paulfaget/SalamanderSensorDataLoggerProject/Images/Overview.jpg

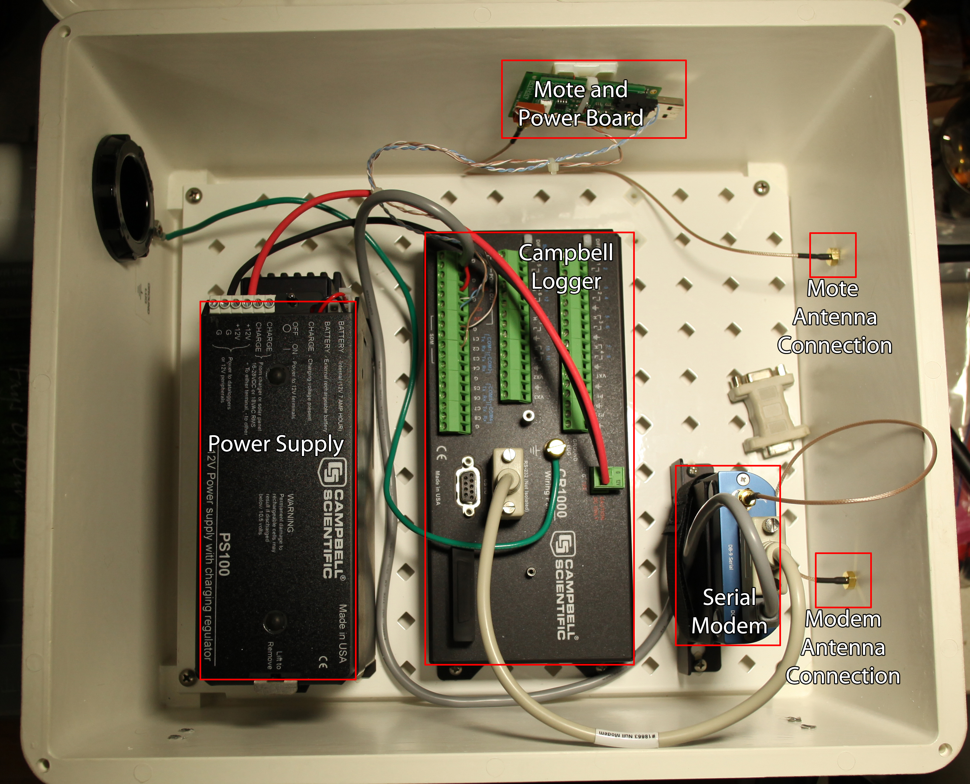
Images/Overview.jpg
