paulfaget/SalamanderSensorDataLoggerProject/Images/Mote.jpg

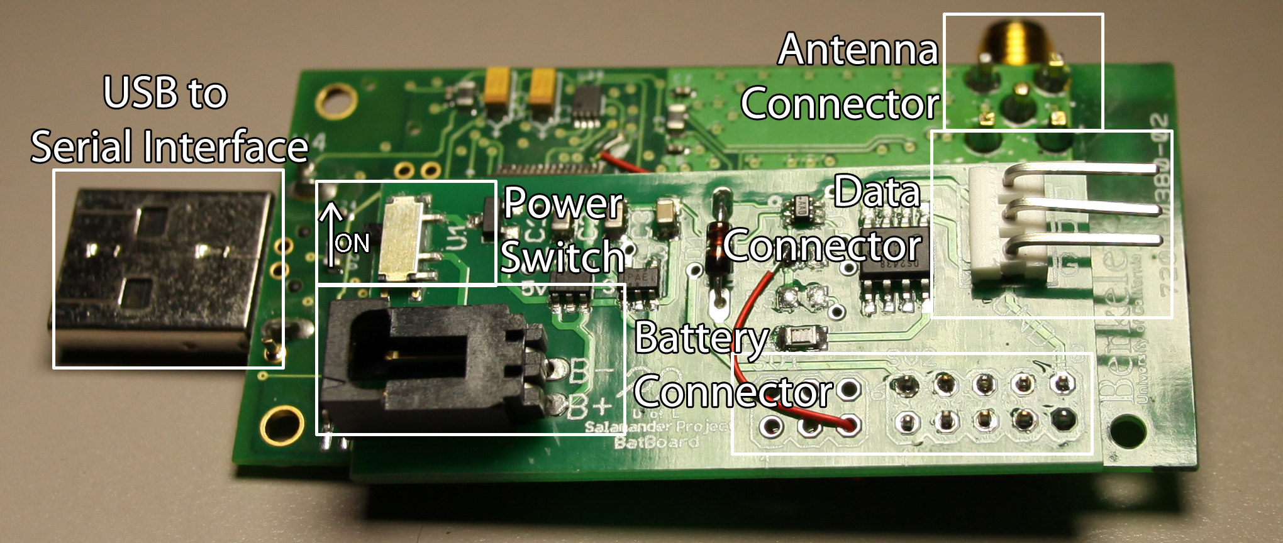
Images/Mote.jpg
