paulfaget/SalamanderSensorDataLoggerProject/Images/Campbell.jpg

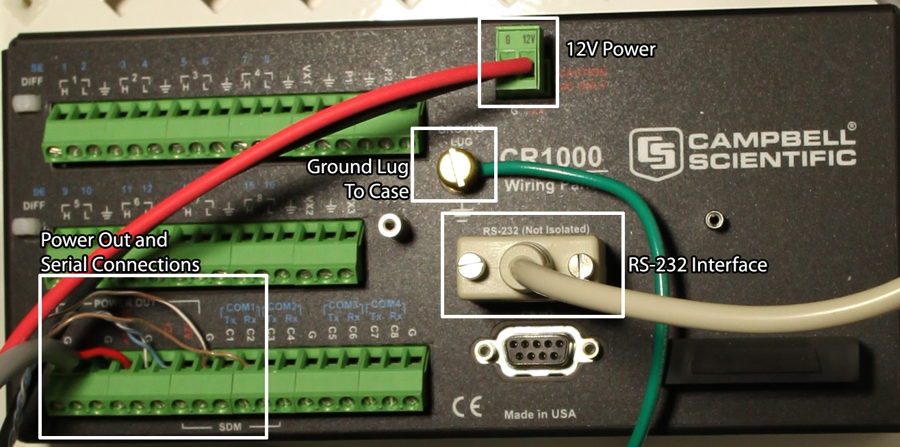
Images/Campbell.jpg
