paulfaget/SalamanderSensorDataLoggerProject/Images/Modem.jpg

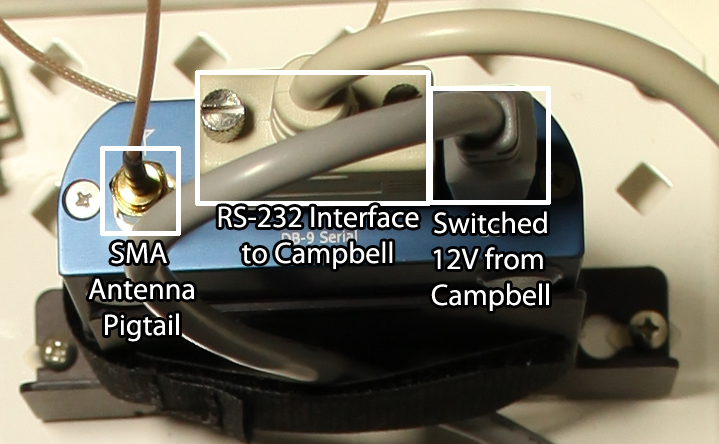
Images/Modem.jpg
