paulfaget/SalamanderSensorDataLoggerProject/Images/Power Source.jpg

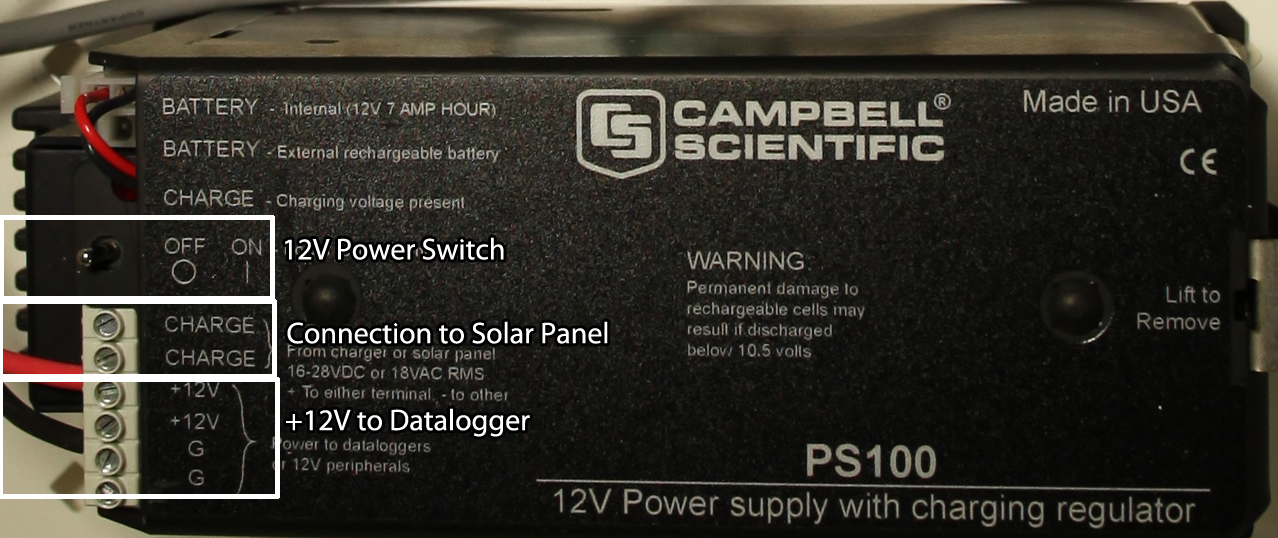
Images/Power Source.jpg
