paulfaget/SalamanderSensorDataLoggerProject/Power Board/BOM.xls

Salamander PowerBoard
Bill of Materials
Label | Purpose | Value | PKG | Digi-Key PN | Sparkfun PN
R1 | 1-Wire Pullup | 4.7kΩ | 805 | RR12P4.7KDCT-ND
R2 | UART Level Translator | 0Ω | 805
R3 | 1Wire Level Translator | 0Ω | 805
C1 | 5V Filter Cap | 4.7uF | 805 | 587-1301-1-ND
C2 | 3V Filter Cap | 4.7uF | 805 | 587-1301-1-ND
C3 | 6V Filter Cap | 1uF | 805 | PCC2319CT-ND
U1 | Reverse Polarity Battery Protection | NFET | SOT-23-3 | IRLML2502PBFCT-ND
U2 | 5V Regulator |  | SOT-23-5 | 296-11012-1-ND
U3 | 3V Regulator |  | SOT-23-5 | 296-11008-1-ND
U4 | Battery Monitor |  | 8-SOIC | DS2438Z+-ND
U5 | Level Translator | 3-5V Bidirectional | SC-70 | MAX3371EXT+TTC-ND
D1 | Current Shunt Diode | 1N4148 | Through Hole
S1 | Power Switch |  |  |  | COM-10860
X1 | 3Pin Sensor Connector | Rectangular RA |  | A19340-ND
X2 | Battery Connector
