paulfaget/SalamanderSensorDataLoggerProject/Power Board/PowerBoard.pdf

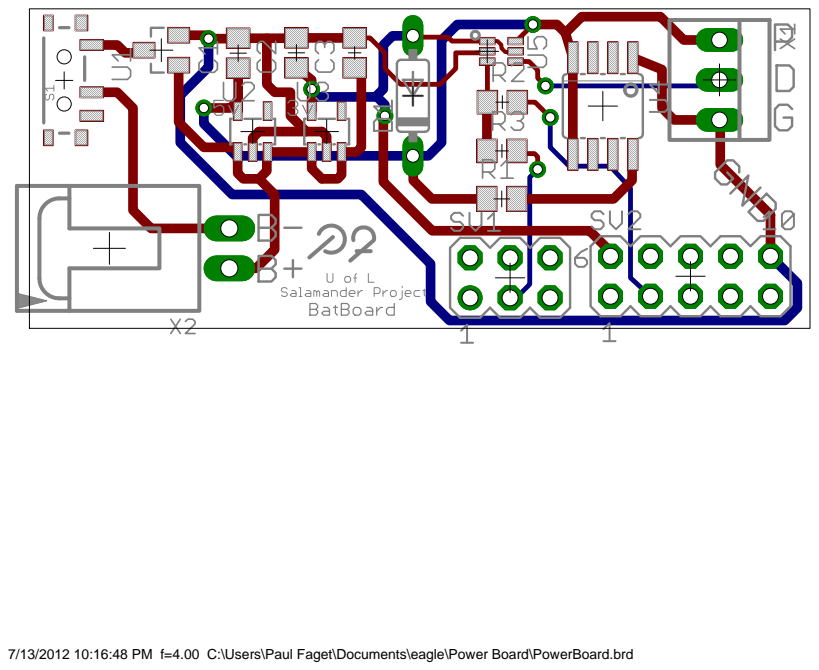
[picture p6: page 1]

7/13/2012 10:16:48 PM f=4.00 C:\Users\Paul Faget\Documents\eagle\Power Board\PowerBoard.brd
