paulfaget/SalamanderSensorDataLoggerProject/(list of files, drawings)

Other design files:
Power Board/Previous Version/ExpressPCB_PowerBoard.pcb
