paulfaget/SalamanderSensorDataLoggerProject/Power Board/PowerBoard.brd

## EAGLE design Power Board/PowerBoard.brd (2012-07-11)

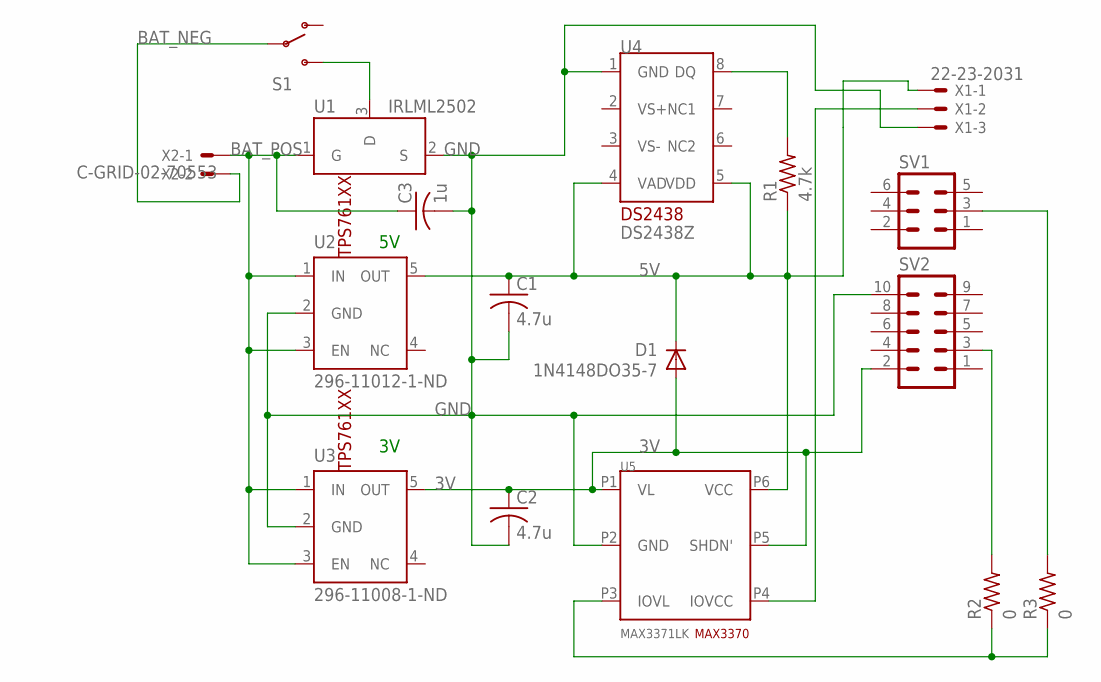
[picture p7: schematic PowerBoard.sch]

Parts:
C1, C2: 4.7u; C0805
C3: 1u; C0805
D1: 1N4148DO35-7; DO35-7
R1: 4.7k; M0805
R2, R3: 0; R0805
S1: SWITCH-SPST-SMD-A
SV1: MA03-2
SV2: MA05-2
U1: IRLML2502; SOT23
U2: 296-11012-1-ND; SOT23-DBV
U3: 296-11008-1-ND; SOT23-DBV
U4: DS2438Z; SOIC08
U5: MAX3371LK; 6-LEAD-SC70
X1: 22-23-2031
X2: C-GRID-02-70553; 70553-02

Connections:
3V: C2.1, D1.A, SV2.2, U3.5 (OUT), U5.P1 (VL), U5.P5 (SHDN')
5V: C1.1, D1.C, R1.1, U2.5 (OUT), U4.4 (VAD), U4.5 (VDD), U5.P6 (VCC), X1.1
BAT_NEG: S1.2, X2.2
BAT_POS: C3.1, U1.1 (G), U2.1 (IN), U2.3 (EN), U3.1 (IN), U3.3 (EN), X2.1
GND: C1.2, C2.2, C3.2, SV2.10, U1.2 (S), U2.2 (GND), U3.2 (GND), U4.1 (GND), U5.P2 (GND), X1.3
unnamed: R2.1, R3.1, U5.P3 (IOVL)
unnamed: S1.3 (S), U1.3 (D)
unnamed: R1.2, U4.8 (DQ)
unnamed: U5.P4 (IOVCC), X1.2
unnamed: R3.2, SV1.3
unnamed: R2.2, SV2.3

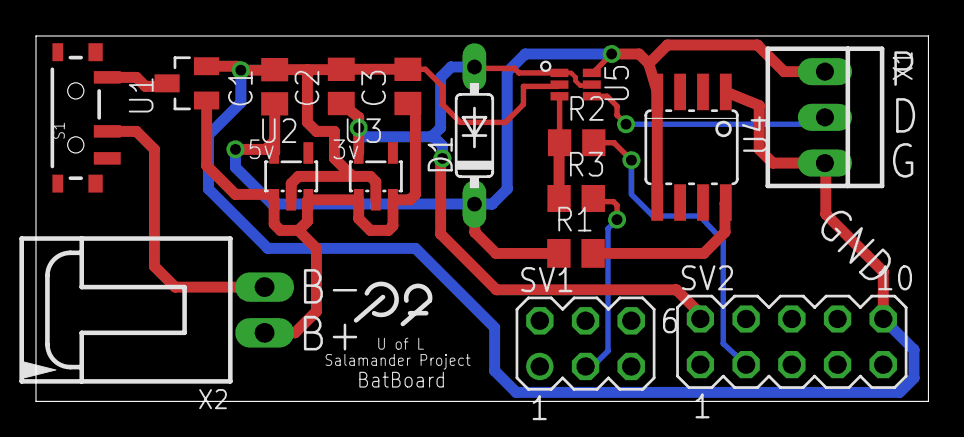
[picture p8: board PowerBoard.brd from above]

Board: 2 copper layers, 49.6 x 20.3 mm, 17 parts (0 on the bottom side), 11 nets.
