paulfaget/SalamanderSensorDataLoggerProject/(commit log)

2012-07-11 Initial commit
    This was the version of the Power Board that was sent out for
    production. It came back with a successful, functional, build.
    [ExpressPCB_PowerBoard.pcb, PowerBoard.brd, PowerBoard.sch]
2012-07-14 Two files added
    Added a colorized and enlarged PDF of the board as well as a README
    describing its functionality.
2012-07-20 Project "wrapup"
    Added images of enclosure, README to explain connections and layout, and
    Wrapup.txt explaining where the project still needs to be taken.
    [BOM.xls]
